cristianfelipea/sumo/INFORME/ANEXO SUMO (3).docx

1. Especificaciones Llanta.


2. Esquemático Sensor Infrarrojo.


3. Diseño MicroMotor

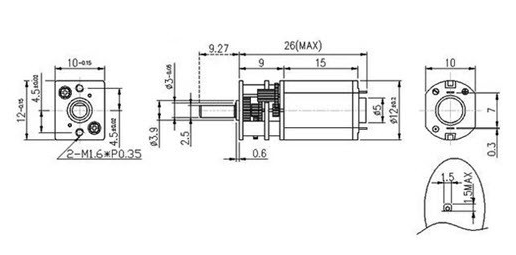
[picture p9: figure]

4. Diseño estructura.
  4.1. Chasis


  4.2. Base


  4.3. Motor Holder


  4.4. Pala


  4.5. Tapa


5. Esquemático


6. Tabla de componentes y costos

ELEMENTO | REFERENCIA | CANTIDAD | PRECIO UNIDAD | PRECIO TOTAL
Micro motor | HPCB 50:1/2.2 Kg-cm/625rpm | 2 | $ 56.000 | $ 112.000
Sensor infrarrojo | Sharp Análogo (4-30cm) | 4 | $ 25.000 | $ 100.000
Soporte | Soporte para micro motor | 2 | $ 15.000 | $ 30.000
Sensor infrarrojo | QRD1114 | 2 | $ 3.200 | $ 6.400
Rueda | Rueda para mini sumo | 2 | $ 35.000 | $ 70.000
Batería | Batería Lipo | 1 | $ 51.979 | $ 51.979
Driver de motor | Driver de motor L293D | 1 | $ 4.000 | $ 4.000
Micro controlador | SMT32F103C8T6 (Blue Pill) | 1 | $ 18.500 | $ 18.500
Módulo Wifi | Módulo Wifi - ESP8266 | 1 | $ 9.000 | $ 9.000
Regulador | AMS1117 | 1 | $ 2.300 | $ 2.300
Regulador | Lm7805 TO-220 | 1 | $ 1.500 | $ 1.500
Resistencia | Resistencia 1/4 W | 11 | $ 20 | $ 220
Capacitores | Condensador electrolítico de montaje | 5 | $ 100 | $ 500
Diodo Zener | Diodo Zener DO-41 (DO-204AL) de 3.6V | 1 | $ 200 | $ 200
Bornera | Bornera 2 pines | 3 | $ 600 | $ 1.800
Plata | Placa de cobre | 1 | $ 1.500 | $ 1.500
Pulsador | Pulsador NA, tipo Through-hole-mounting. | 1 | $ 200 | $ 200
Switch | Interruptor encendido/apagado | 1 | $ 2.000 | $ 2.000
COSTO TOTAL | | | | $ 412.099

7. Diagrama de Flujo

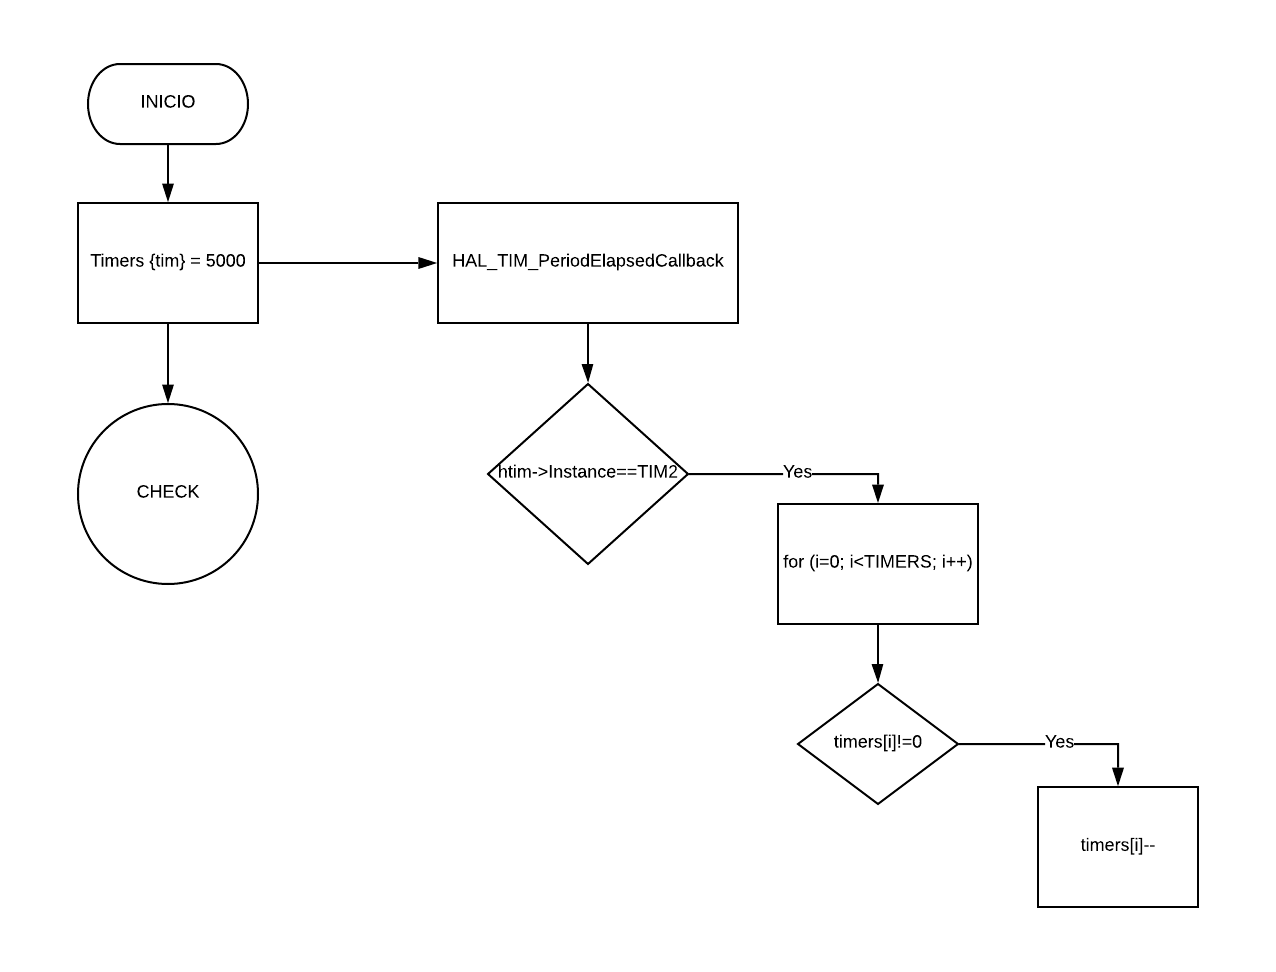
[picture p10: figure]

8. Máquina de Estados

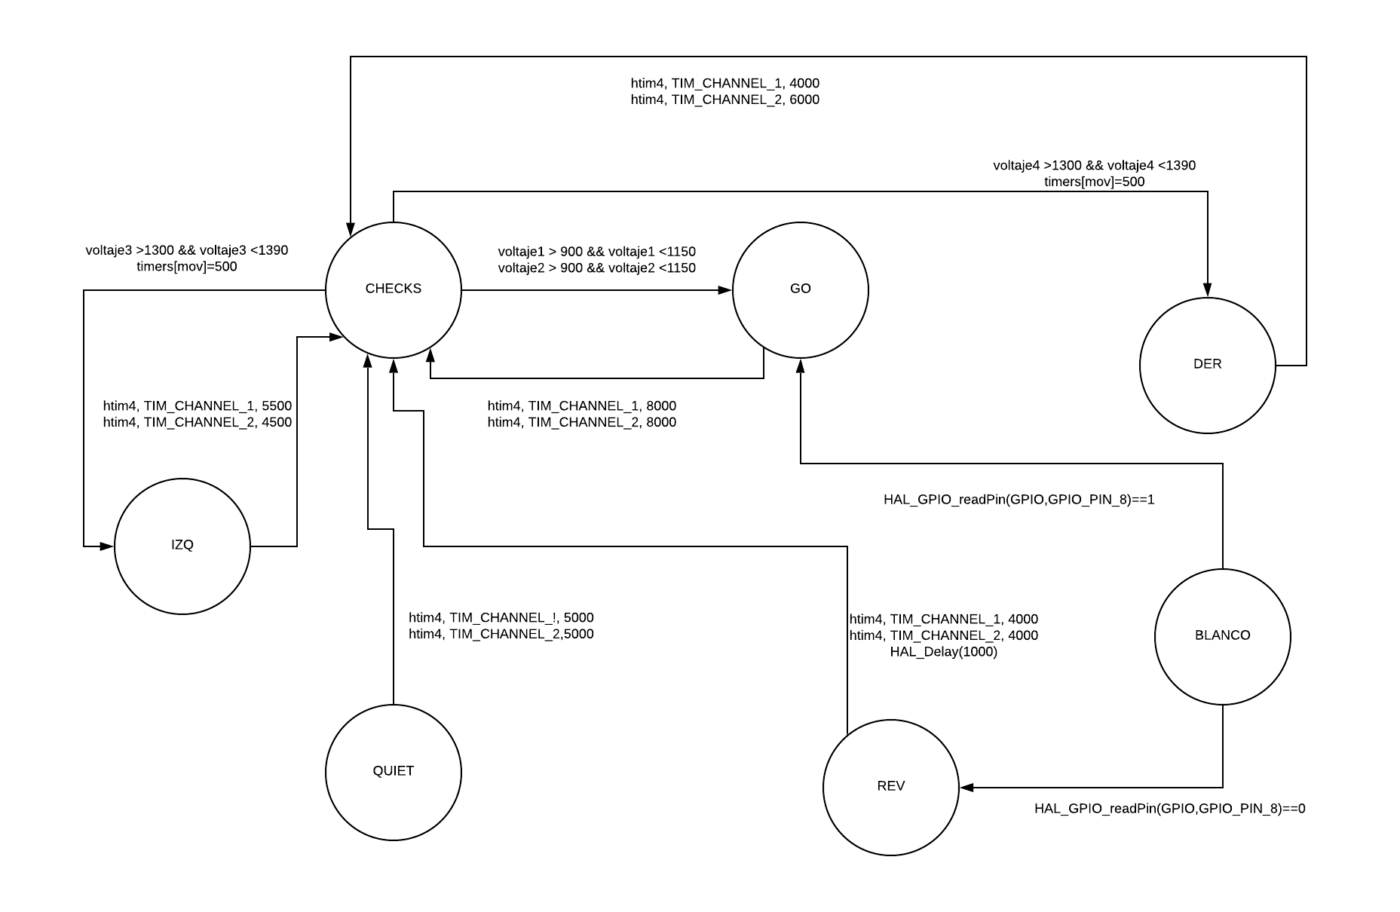
[picture p11: figure]

Ingeniería Electrónica Curso: Sistemas Embebidos Proyecto Sumo
