cristianfelipea/sumo/INFORME/ANEXO SUMO (2).docx

1. Especificaciones Llanta.


2. Esquemático Sensor Infrarrojo.


3. Diseño estructura.
  3.1. Chasis


  3.2. Base


  3.3. Motor Holder


  3.4. Pala


  3.5. Tapa


4. Esquemático


Ingeniería Electrónica Curso: Sistemas Embebidos Proyecto Sumo
