cristianfelipea/sumo/CADS/DISEÑO ESTRUCTURA 1.pdf

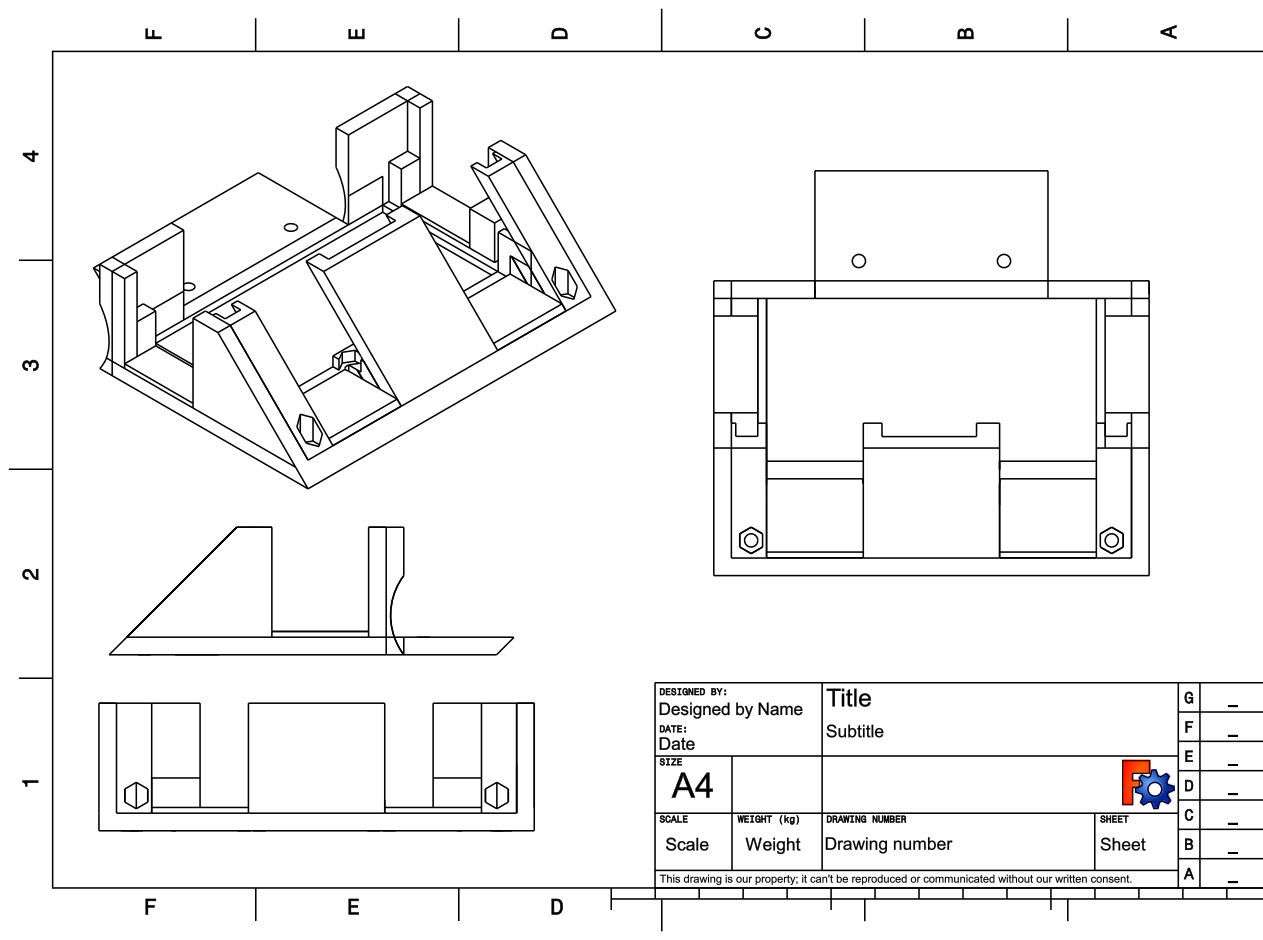
[picture p14: page 1]
