cristianfelipea/sumo/CADS/BASE.pdf

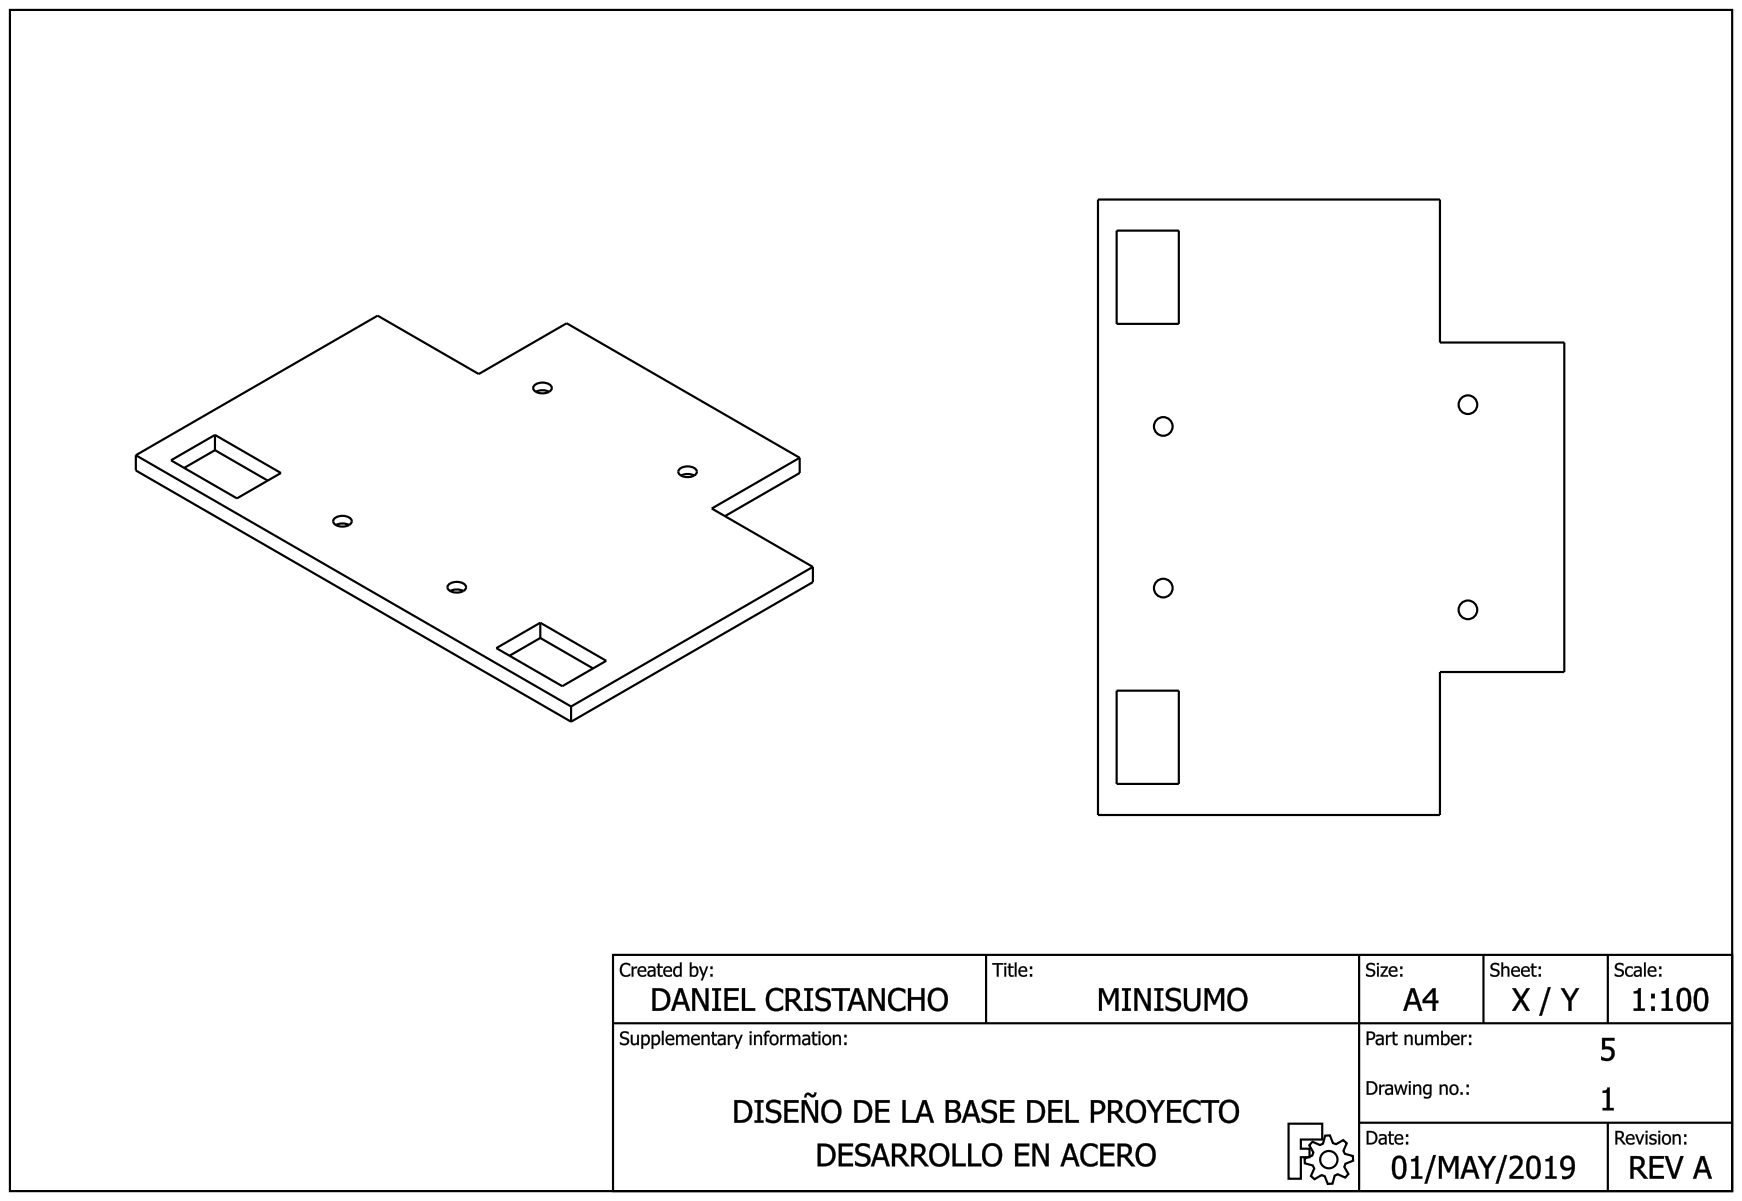
[picture p15: page 1]
