cristianfelipea/sumo/CADS/CHASIS (1).pdf

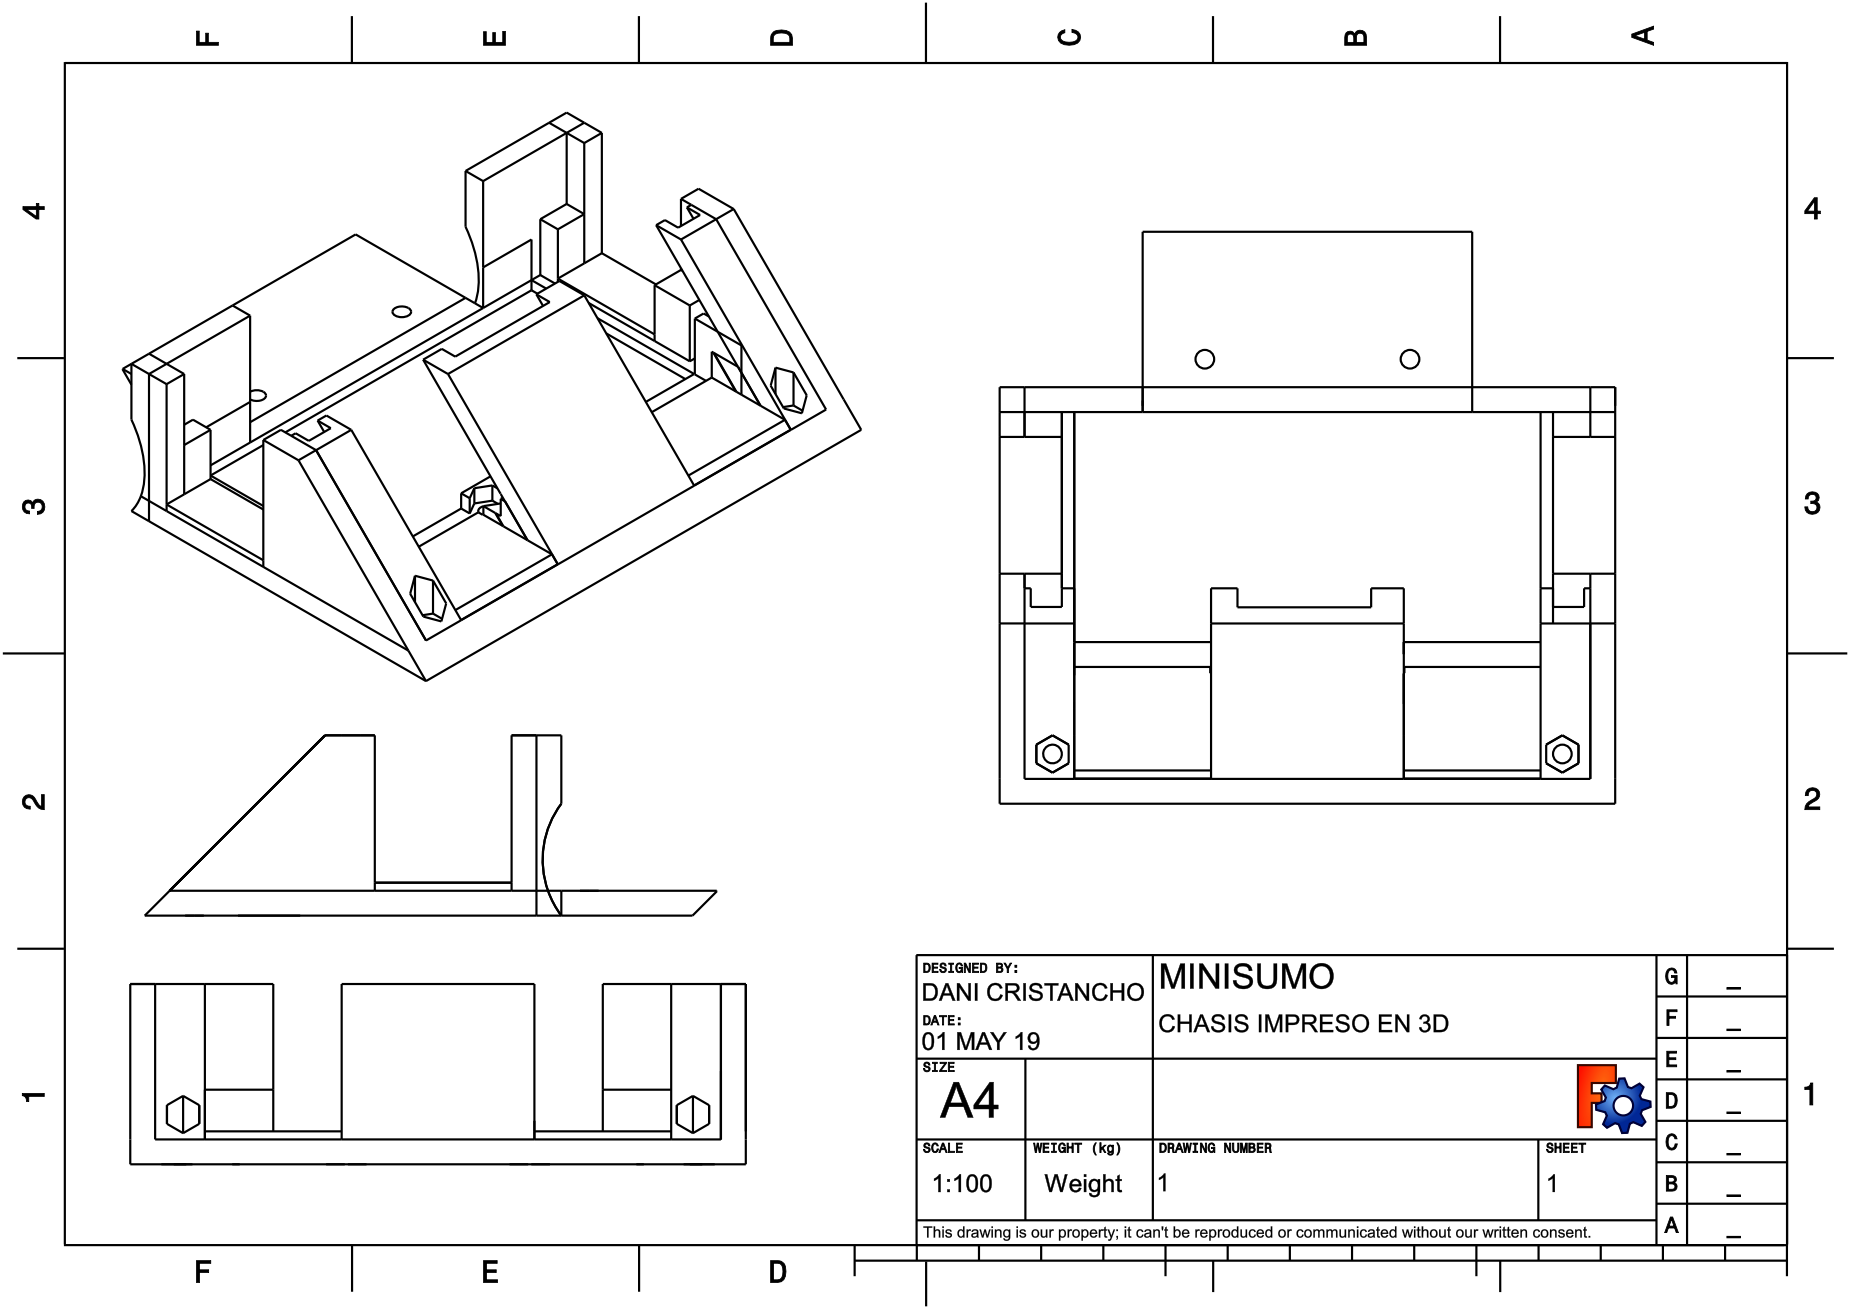
[picture p16: page 1]
