cristianfelipea/sumo/CADS/MOTOR HOLDER.pdf

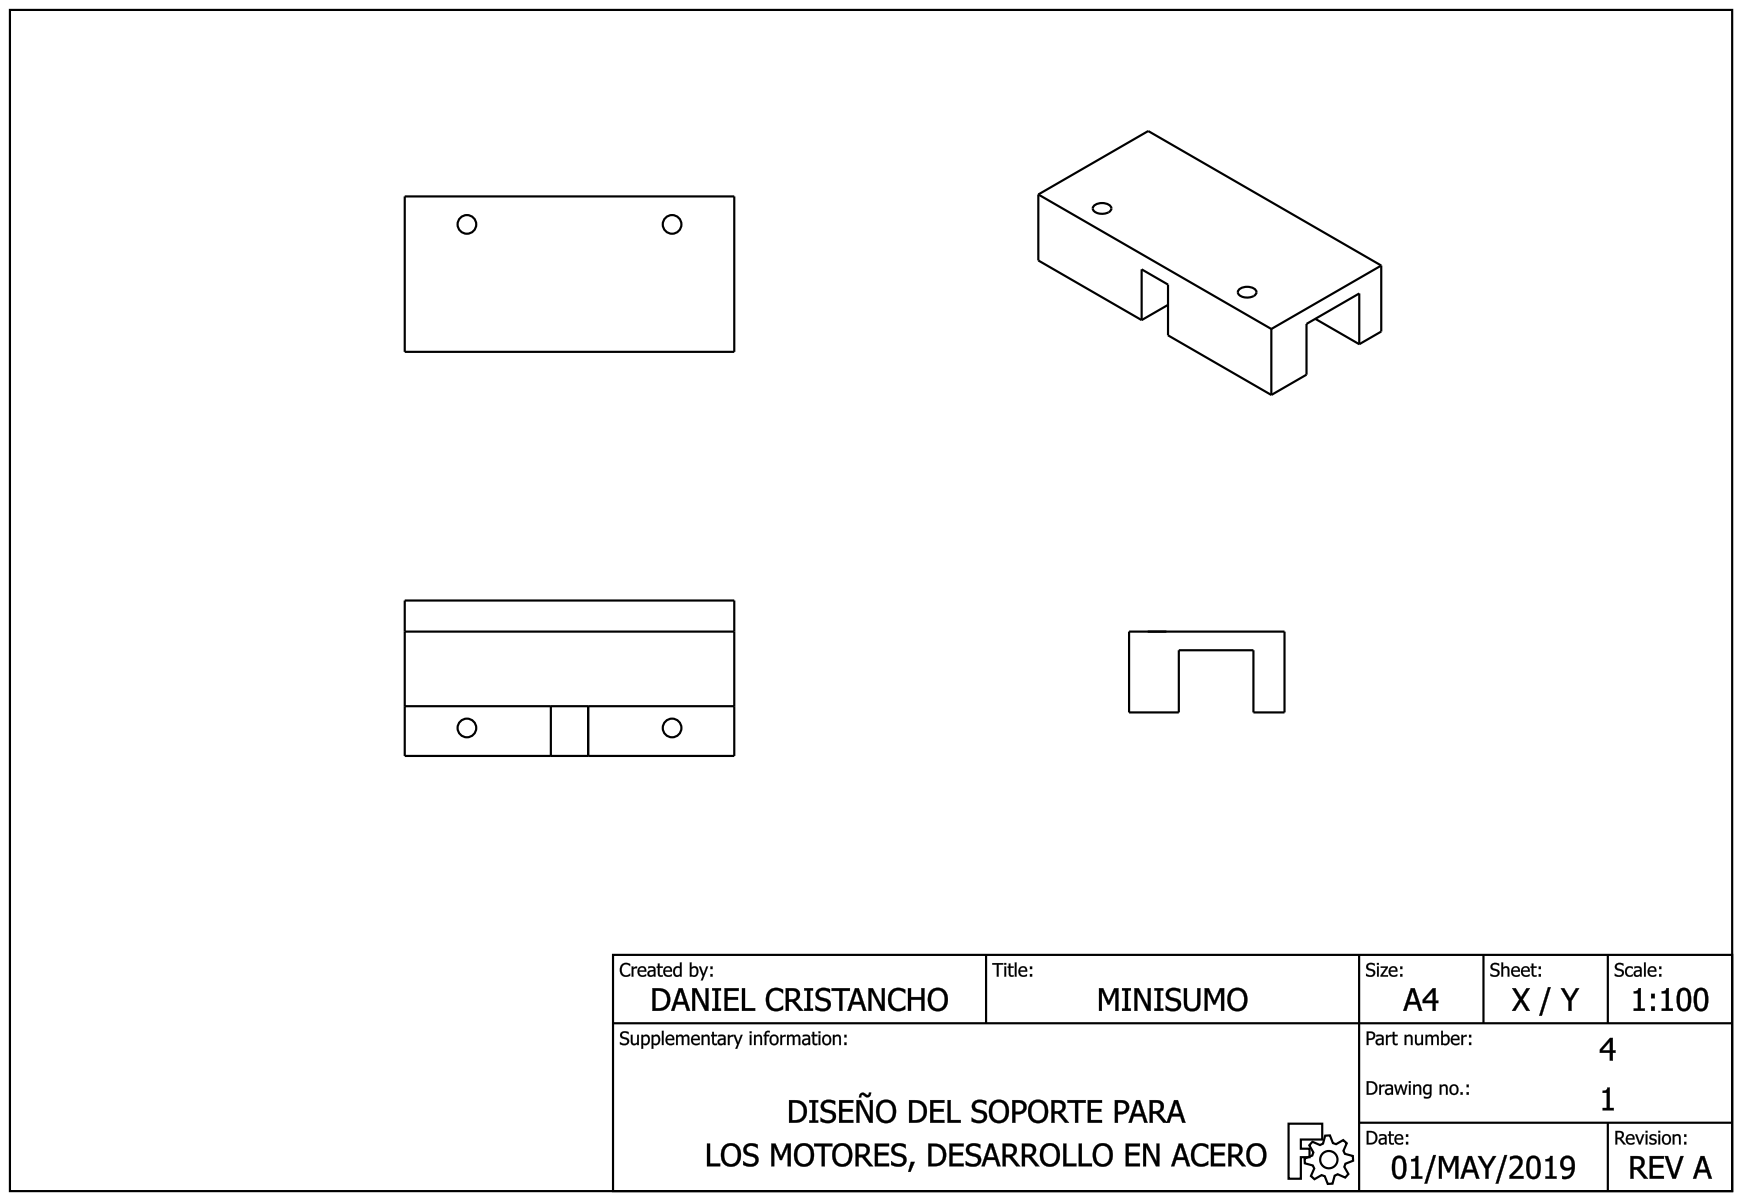
[picture p17: page 1]
