cristianfelipea/sumo/CADS/PALA.pdf

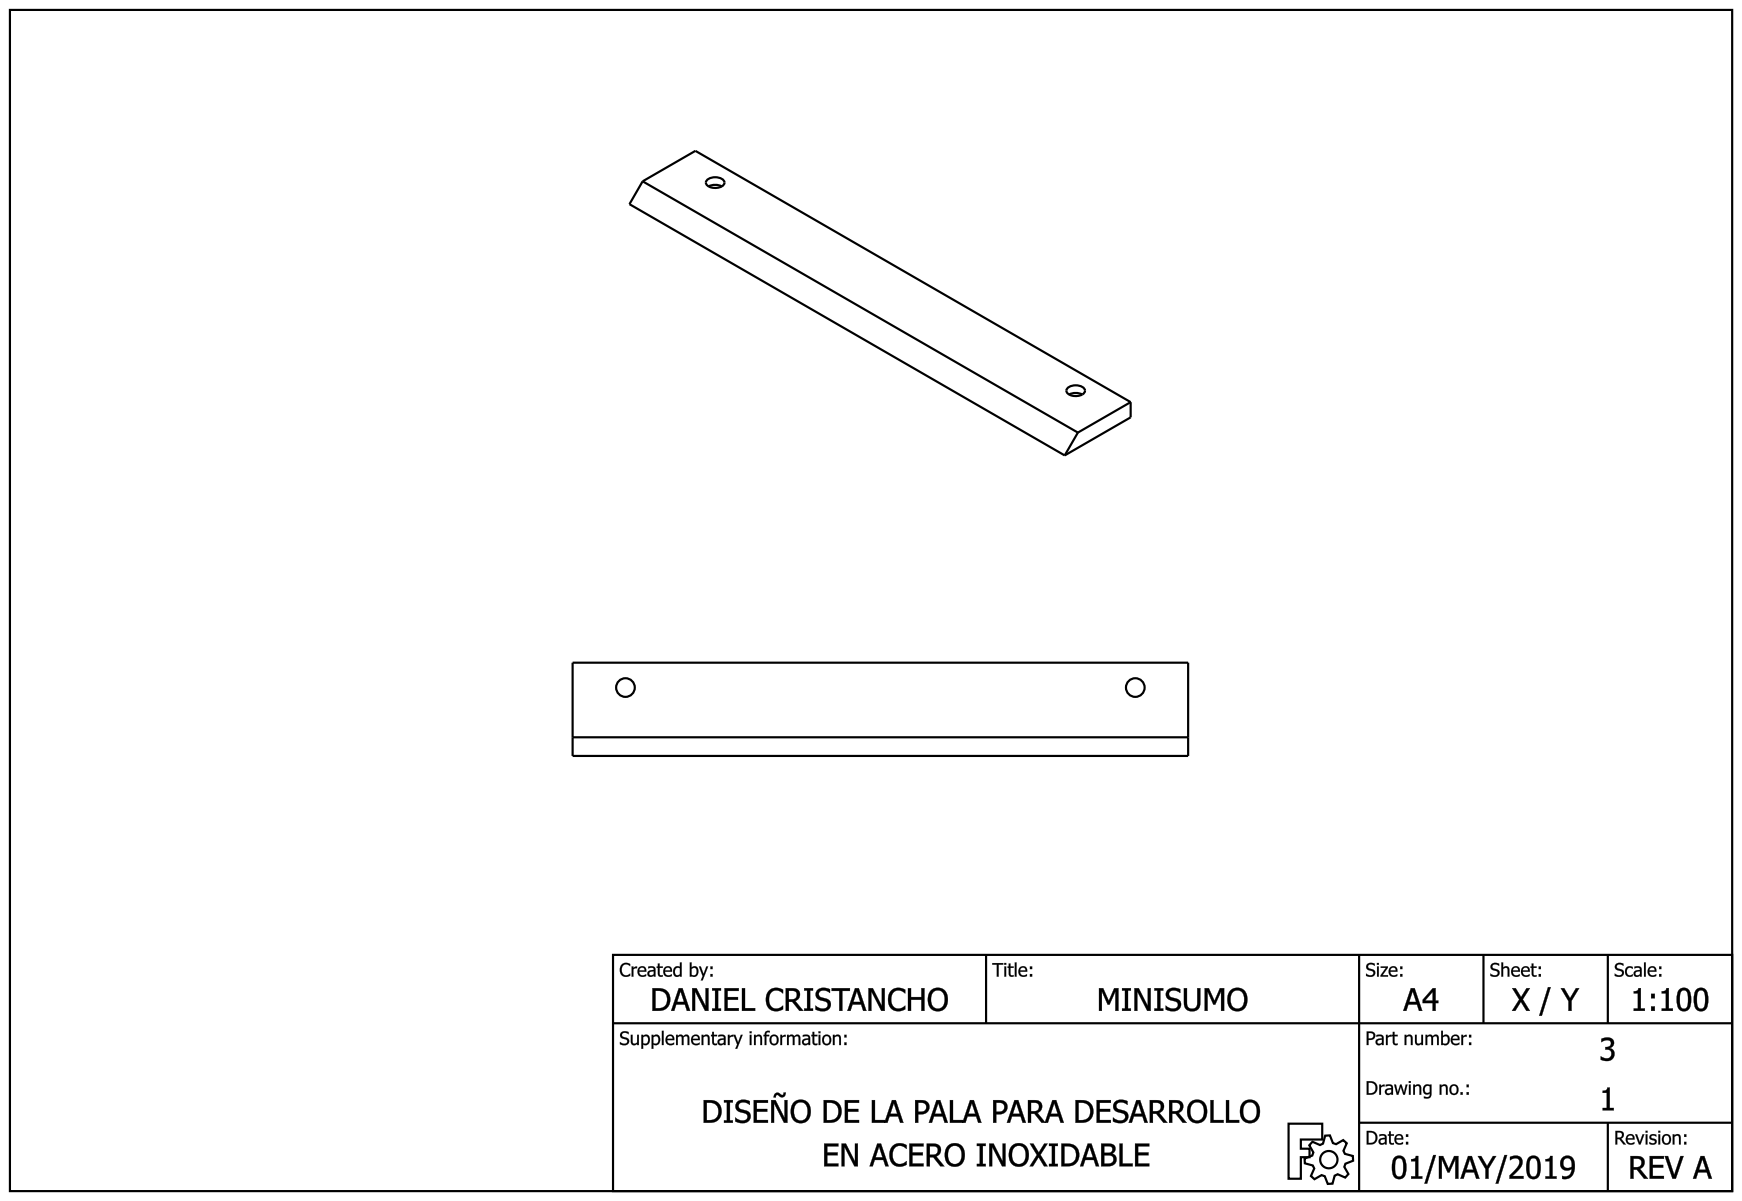
[picture p18: page 1]
