cristianfelipea/sumo/CADS/TAPA.pdf

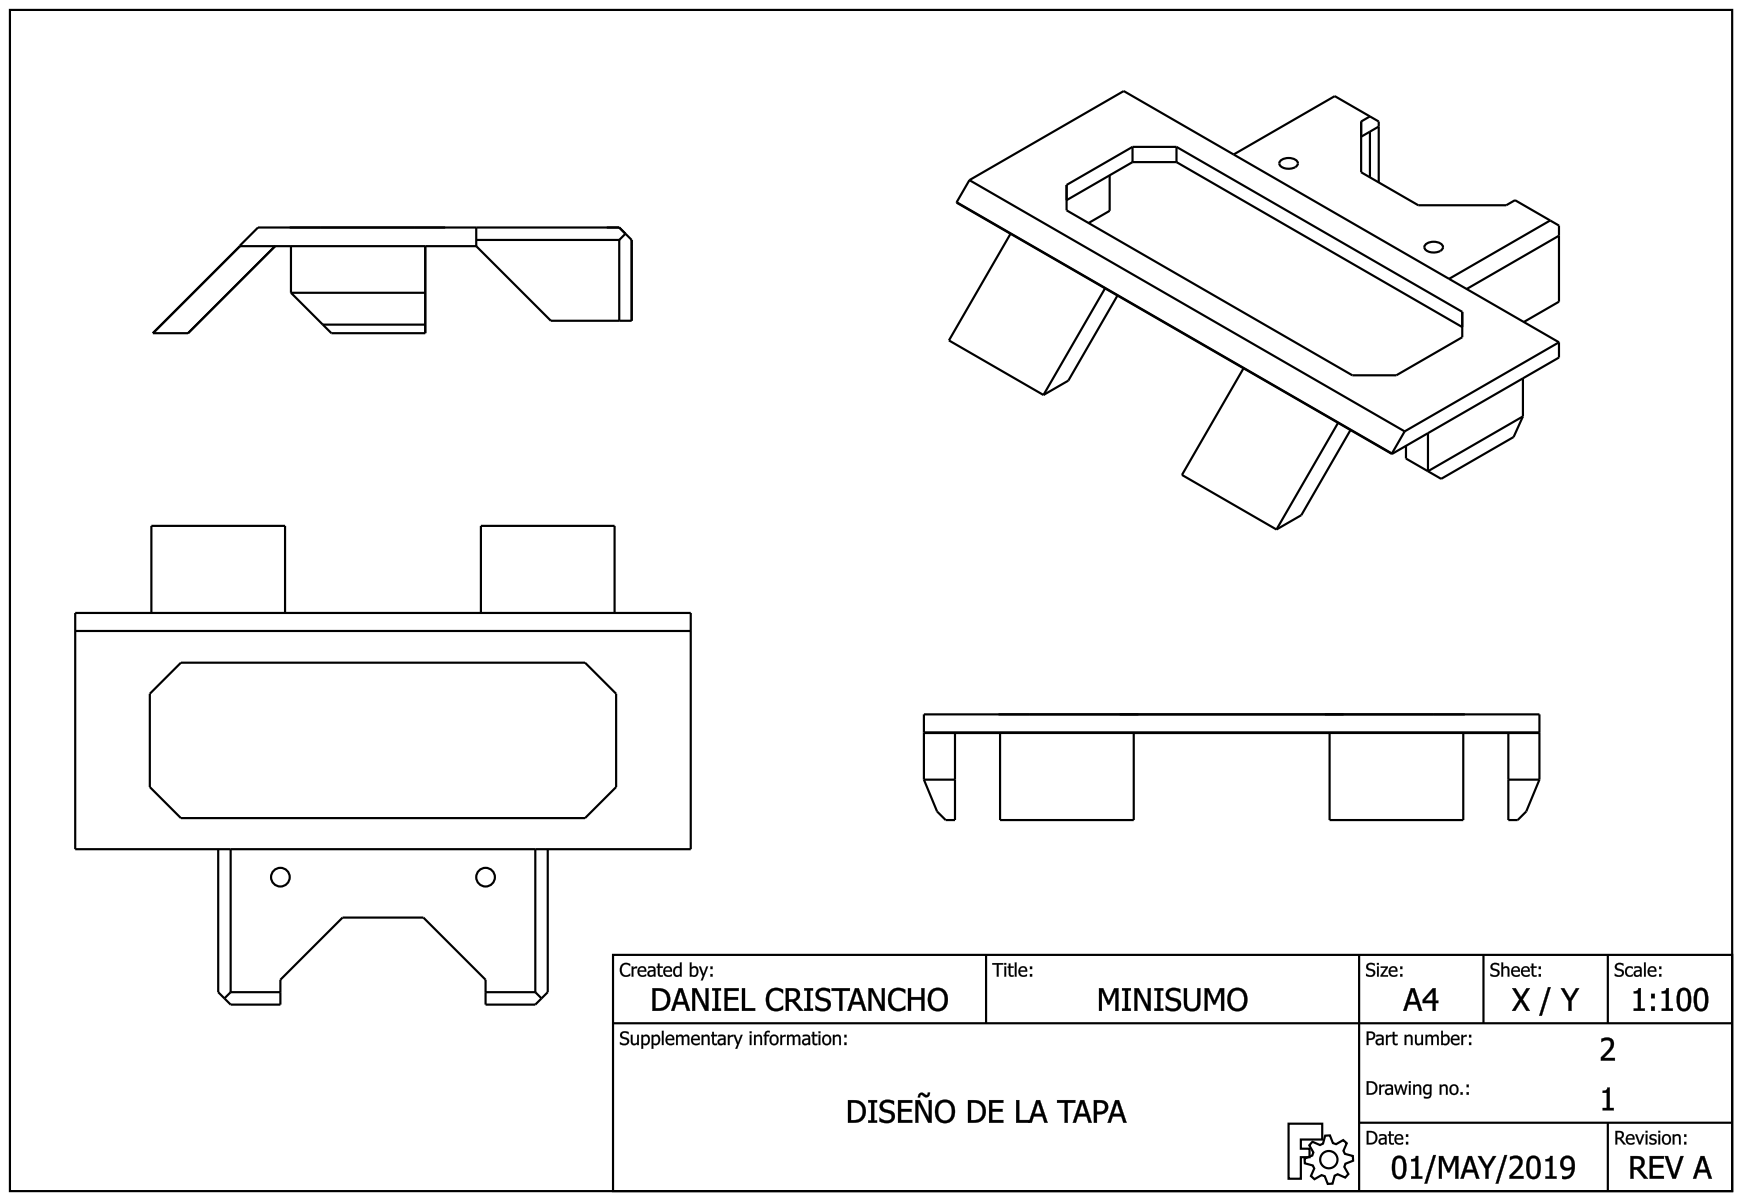
[picture p19: page 1]
