cristianfelipea/sumo/CADS/PlanoRuedasSumoAluminio.pdf

A ( 2 : 1 )

# CNC

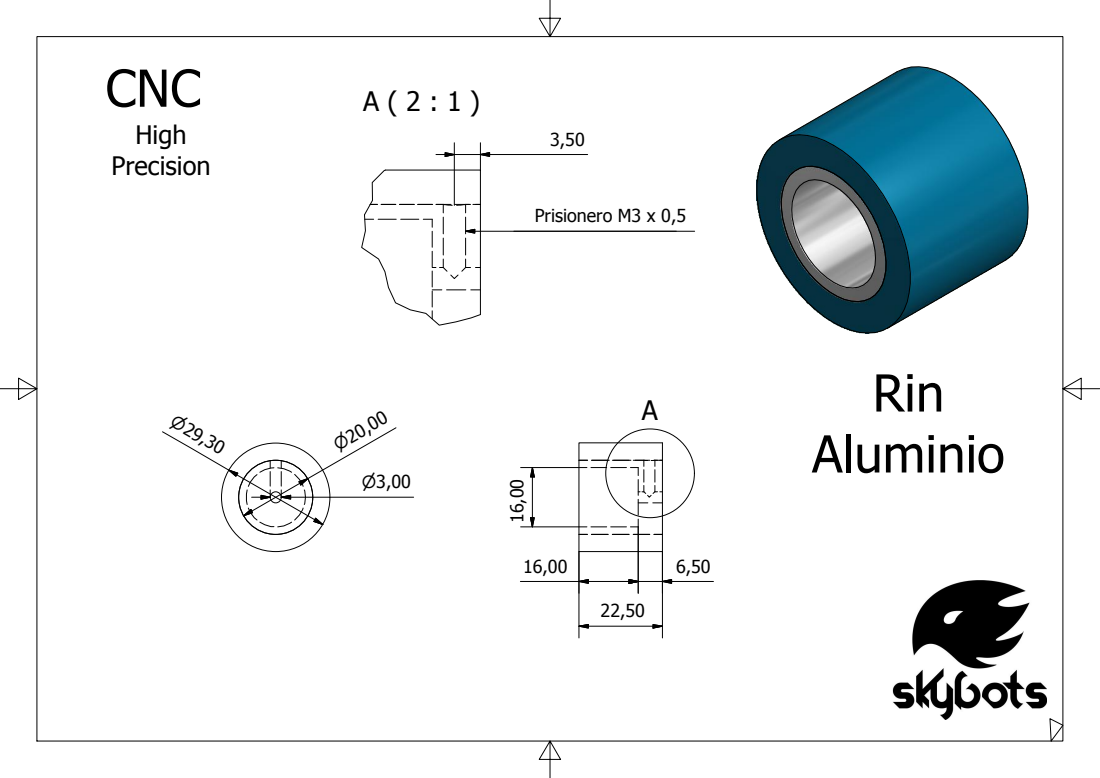
[picture p20: page 1]
Prisionero M3 x 0,5; Rin Aluminio; High Precision
