cristianfelipea/sumo/CODIGO/maquinas/Src/main.c

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

/* Includes ------------------------------------------------------------------*/
#include "main.h"
#include "usb_device.h"

/* USER CODE BEGIN PD */
enum{//me va servir para manear tiempos
		TLED_1=0,
		TLED_2,
		mov,
		mov1,
		mov2,
		mov3,

		TIMERS,

 };
typedef enum{
	QUIET=0,
	GO,
	DER,
	IZQ,
	CHECK,
	CHECKS,
	REV,

}ST;
typedef enum{
	P_PUSH=0,
	P_CHECK,
}ST_P;

/* USER CODE END PD */

ADC_HandleTypeDef hadc1;

TIM_HandleTypeDef htim1;
TIM_HandleTypeDef htim2;
TIM_HandleTypeDef htim4;

/* USER CODE BEGIN PV */


ST  st_m=QUIET, st_s=CHECKS;
ST_P st_p1=P_CHECK,st_p2=P_CHECK,st_p3=P_CHECK,st_p4=P_CHECK;

volatile uint16_t timers[TIMERS];
volatile char copia[64];
volatile int voltaje, voltaje1,voltaje2,voltaje3,voltaje4,voltaje0,funciona;
/* USER CODE END PV */

void SystemClock_Config(void);
static void MX_GPIO_Init(void);
static void MX_TIM1_Init(void);
static void MX_TIM2_Init(void);
static void MX_TIM4_Init(void);
static void MX_ADC1_Init(void);
/* USER CODE BEGIN PFP */
void CDC_Receive_Callback(uint8_t *buf,uint32_t len);
void led1_process();
void check();
void checks();
void ADC();
void ADCD();
void ADCDD();
void ADCDDD();

/* USER CODE END PFP */

/**
  * @brief  The application entry point.
  * @retval int
  */
int main(void)
{
  /* MCU Configuration--------------------------------------------------------*/

  /* Reset of all peripherals, Initializes the Flash interface and the Systick. */
  HAL_Init();

  /* Configure the system clock */
  SystemClock_Config();

  /* Initialize all configured peripherals */
  MX_GPIO_Init();
  MX_TIM1_Init();
  MX_USB_DEVICE_Init();
  MX_TIM2_Init();
  MX_TIM4_Init();
  MX_ADC1_Init();
  /* USER CODE BEGIN 2 */
  HAL_TIM_Base_Start_IT(&htim2);
  /* USER CODE END 2 */

  /* Infinite loop */
  /* USER CODE BEGIN WHILE */

  /*while(1){
	if(HAL_GPIO_ReadPin(GPIOB, GPIO_PIN_12)==0 ){


		 HAL_GPIO_WritePin(GPIOC, GPIO_PIN_13, 1);
		  		}

	else{
		HAL_GPIO_WritePin(GPIOC, GPIO_PIN_13, 0);
	}
}

*/





HAL_TIM_PWM_Start(&htim4,TIM_CHANNEL_1);
HAL_TIM_PWM_Start(&htim4,TIM_CHANNEL_2);
__HAL_TIM_SET_COMPARE(&htim4,TIM_CHANNEL_1,0);
__HAL_TIM_SET_COMPARE(&htim4,TIM_CHANNEL_2,5000);
HAL_Delay(5 000);

  while (1)
  {

	checks();
	 ADC();
	 ADCD();


    /* USER CODE END WHILE */

    /* USER CODE BEGIN 3 */
  }
  /* USER CODE END 3 */
}

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
/* USER CODE BEGIN 4 */
void HAL_TIM_PeriodElapsedCallback(TIM_HandleTypeDef *htim)
{
	if(htim->Instance==TIM2){
		int i;
		for(i=0;i< TIMERS;i++){
			if(timers[i]!=0){
				timers[i]--; //resta los tiempos donde sean diferentes de cero
		}

	}
	}
}



void check(){
	switch(st_m){

	case CHECKS:
		//del B12 al B15 son los char, A8 Y A9 QTR
		//ADC de los faros

		//sensor de ataque
		if(voltaje1>900 && voltaje1<1150){//30cm
			st_m=GO;
		}

		//segundo faro

		if(voltaje2>900 && voltaje2<1150){//30cm
		    st_m=GO;
		}


		//sensor de derecho del carrito viendolo de frente


		if(voltaje3>1300 && voltaje3<1390){//30cm
			timers[mov]=500;
			st_m=IZQ;
		}


	  //sensor de izquierdo del carrito viendolo de frente

		if(voltaje4>1300 && voltaje4<1390){//30cm
			timers[mov1]=500;
			st_m=DER;
		}



		//sensor de piso
		if(HAL_GPIO_ReadPin(GPIOA, GPIO_PIN_8)==0){
			st_m=REV;

		}

		else{//blanco
			HAL_GPIO_WritePin(GPIOC, GPIO_PIN_13, 0);
			st_m=GO;
		}

		//revisar sensores
		break;

	case QUIET:
		//apagar motores
		__HAL_TIM_SET_COMPARE(&htim4,TIM_CHANNEL_1,5000);
		__HAL_TIM_SET_COMPARE(&htim4,TIM_CHANNEL_2,5000);
		st_m=CHECKS;
		break;

	case GO:
		__HAL_TIM_SET_COMPARE(&htim4,TIM_CHANNEL_1,4500);//izq
	    __HAL_TIM_SET_COMPARE(&htim4,TIM_CHANNEL_2,7000);
		st_m=CHECKS;
		break;

	case IZQ:
		__HAL_TIM_SET_COMPARE(&htim4,TIM_CHANNEL_1,5500);
	    __HAL_TIM_SET_COMPARE(&htim4,TIM_CHANNEL_2,4500);

		st_m=CHECKS;
		break;

	case DER:
		__HAL_TIM_SET_COMPARE(&htim4,TIM_CHANNEL_1,4000);
	    __HAL_TIM_SET_COMPARE(&htim4,TIM_CHANNEL_2,6000);

		st_m=CHECKS;
		break;

	case REV:
		__HAL_TIM_SET_COMPARE(&htim4,TIM_CHANNEL_1,6000);
		__HAL_TIM_SET_COMPARE(&htim4,TIM_CHANNEL_2,0);
		HAL_Delay(2000);
		st_m=CHECKS;
		break;
	}
}

void ADC(){
	  HAL_ADC_Start(&hadc1);
	HAL_ADC_ConfigChannel(&hadc1,ADC_CHANNEL_0);
	   				// INICIA EL ADC
		 HAL_ADC_PollForConversion(&hadc1,100); 	// MIRA CADA SEGUNDO
		 voltaje1=HAL_ADC_GetValue(&hadc1);
		 voltaje2=((voltaje1*1.1)*1000)/(4096);// OBTIENE EL VALOR DEL ADC
		 HAL_ADC_Stop(&hadc1);
}
void ADCD(){
	HAL_ADC_Start(&hadc1);
	HAL_ADC_ConfigChannel(&hadc1,ADC_CHANNEL_1);
     				// INICIA EL ADC
	 HAL_ADC_PollForConversion(&hadc1,100); 	// MIRA CADA SEGUNDO
	 voltaje3=HAL_ADC_GetValue(&hadc1);
	 voltaje4=((voltaje3*1.1)*1000)/(4096);// OBTIENE EL VALOR DEL ADC
	 HAL_ADC_Stop(&hadc1);
}


void CDC_Receive_Callback(uint8_t *buf,uint32_t len){
	//P=atoi(buf);
	HAL_GPIO_TogglePin(GPIOC,GPIO_PIN_13);
}

/* USER CODE END 4 */
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
