cristianfelipea/sumo/(notices)

Notices in the files:
CODIGO/maquinas/Src/main.c:
Copyright (c) 2019 STMicroelectronics International N.V.
All rights reserved.
(C) COPYRIGHT STMicroelectronics *****END OF FILE
